ryancorp/EEG-Portfolio/hardware/Breadboard.jpg

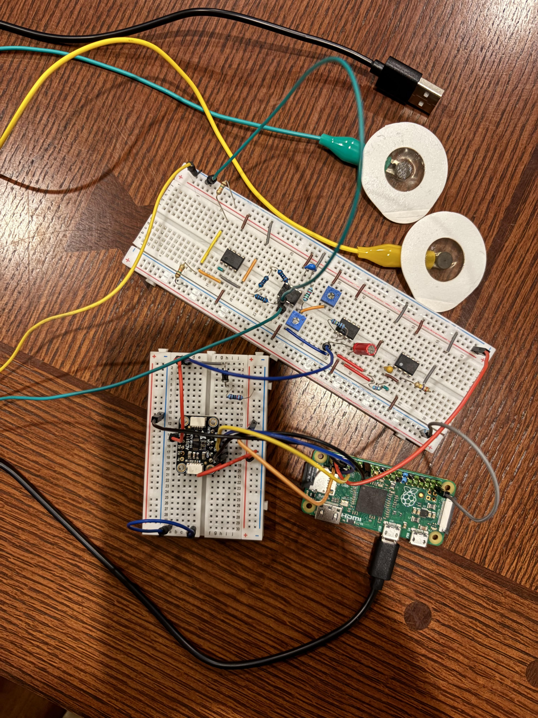
hardware/Breadboard.jpg
