ryancorp/EEG-Portfolio/data_acquisition/Waveform.png

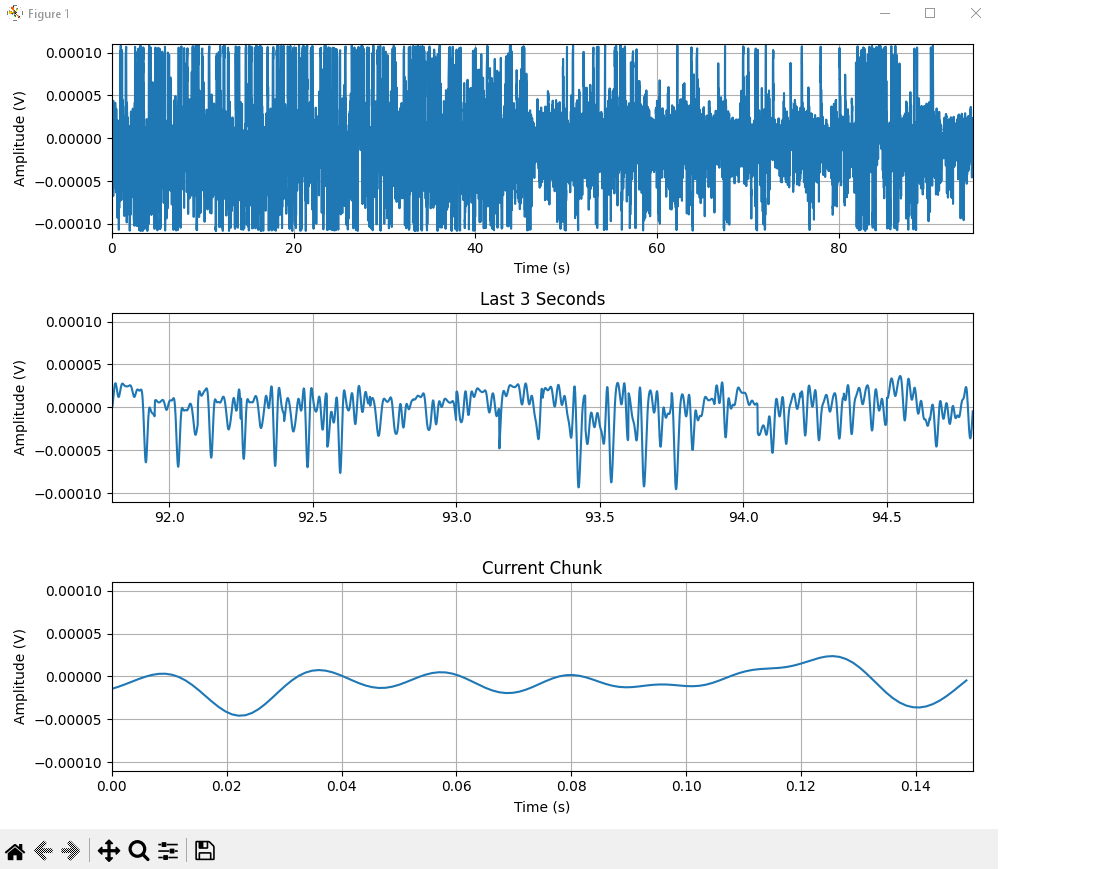
data_acquisition/Waveform.png
