ryancorp/EEG-Portfolio/feature_extraction/Feature_Extraction.png

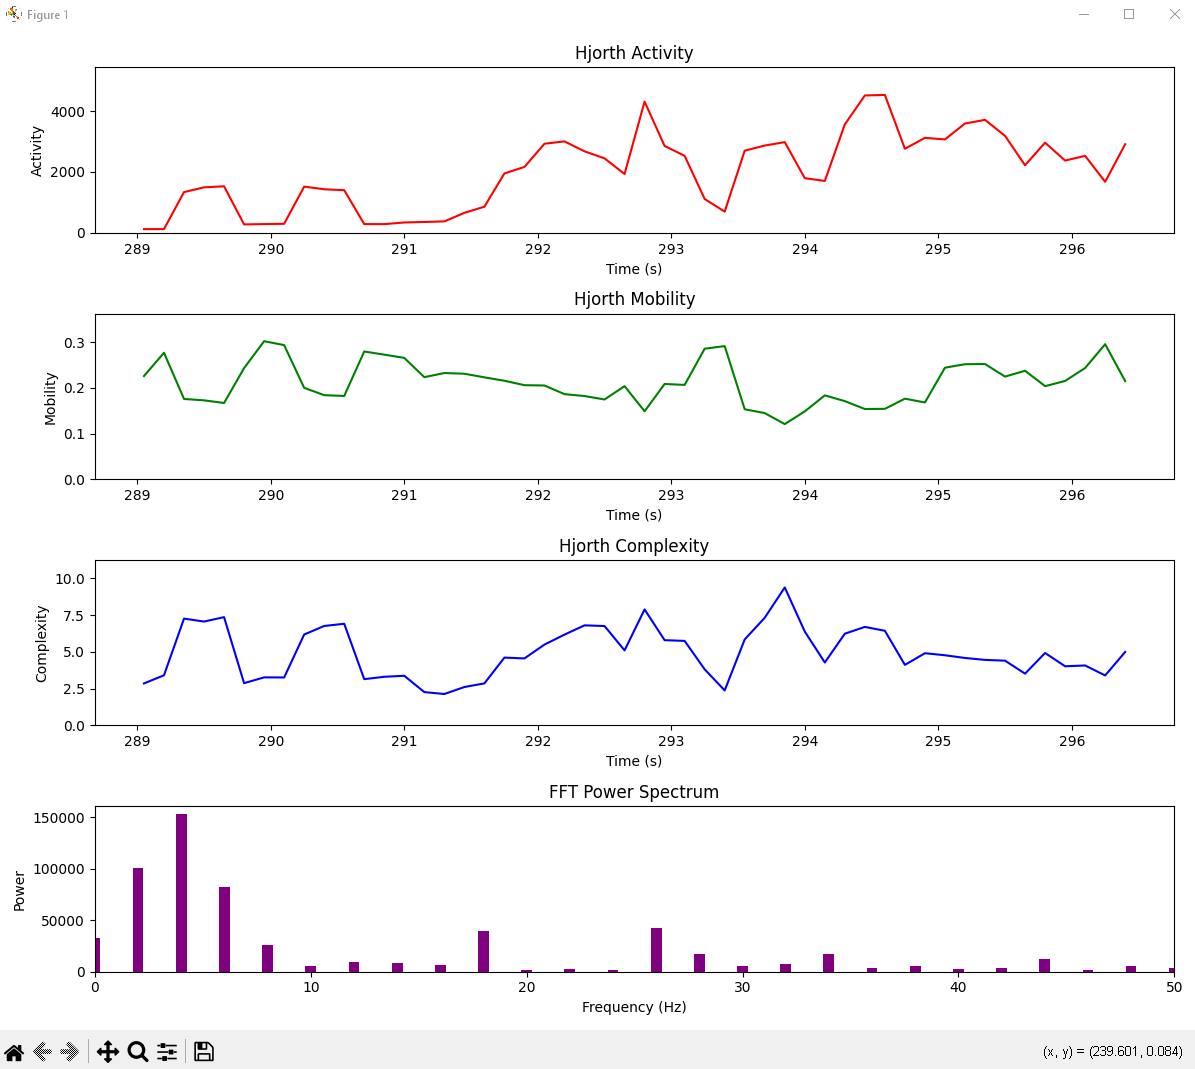
feature_extraction/Feature_Extraction.png
