ryancorp/EEG-Portfolio/hardware/EEG_Circuit.pdf

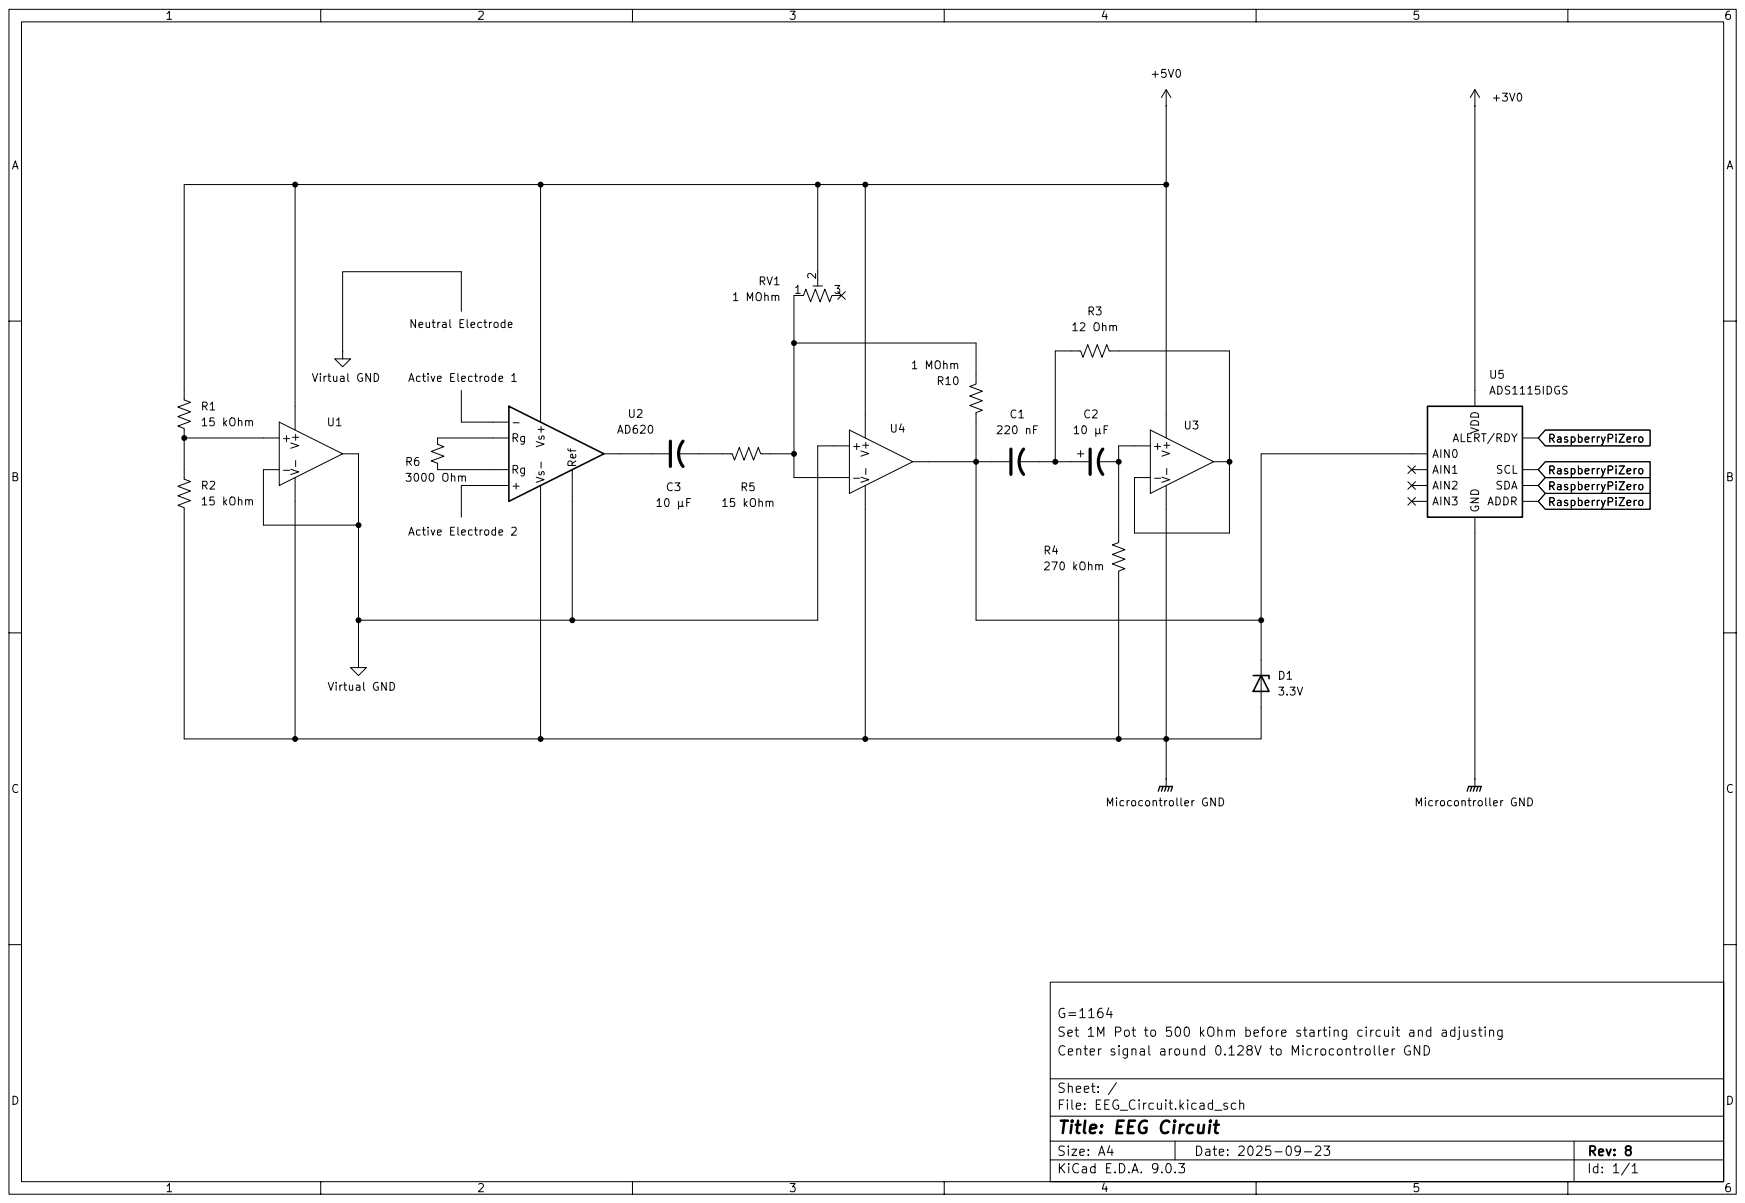
[picture p4: page 1]
