ryancorp/EEG-Portfolio/hardware/EEG_Differential_Mode_ADC_For_Full_Scale_Range.pdf

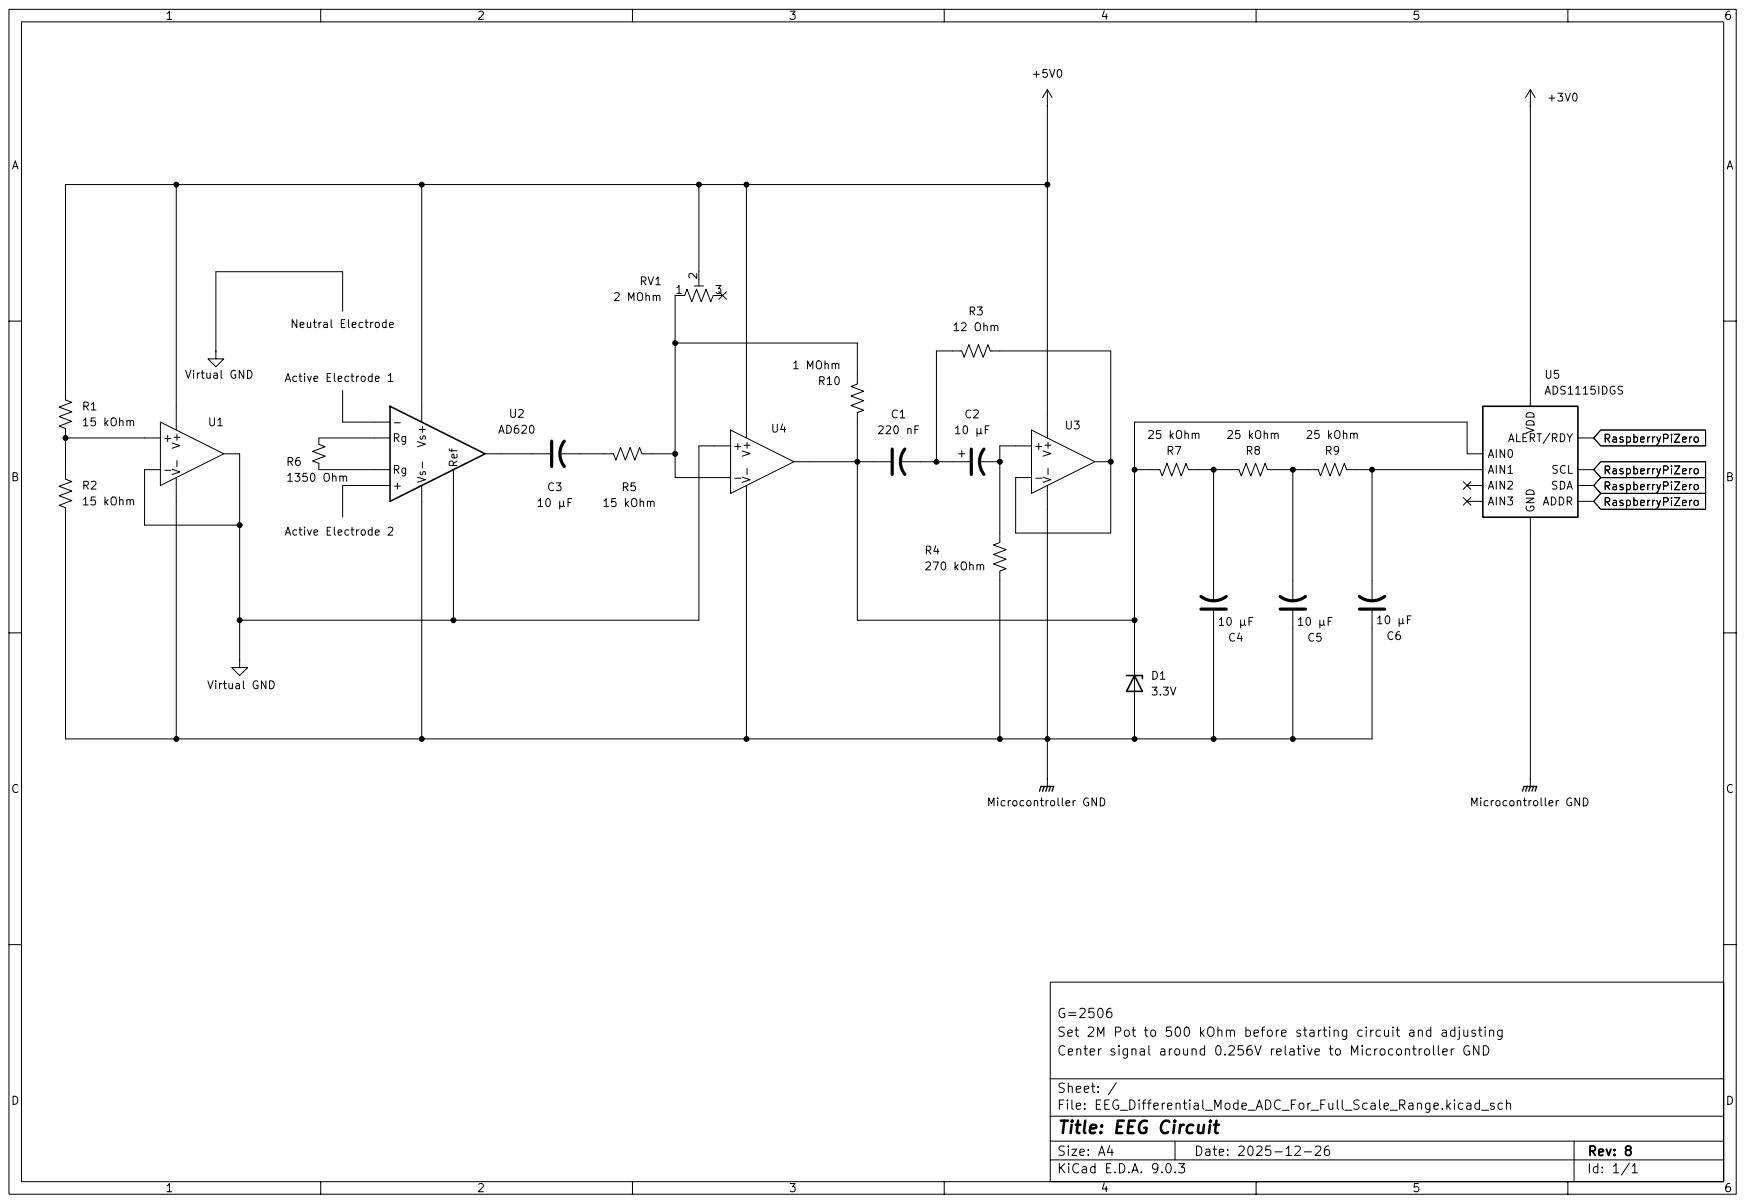
[picture p5: page 1]
