ryancorp/EEG-Portfolio/hardware/EEG LTspice Simulation/EEG_Differential_Into_ADC_For_Full_Scale_Range.asc

C1: cap; 10u
C2: cap; 220n
C3: cap; 10u
C4: cap; 10u
C5: cap; 10u
C6: cap; 10u
D1: diode; 3V3Zener
R1: res; 15k
R2: res; 15k
R3: res; 1350
R4: res; 15k
R5: res; 1Meg
R6: res; 1.114Meg
R7: res; 25k
R8: res; 270k
R9: res; 12
R10: res; 25k
R11: res; 25k
U1: UniversalOpAmp
U2: UniversalOpAmp
U3: UniversalOpAmp
V1: voltage; 5
V2: voltage; SINE(0.0 45u 15 0 0 0); Rser=10k Cpar=10n
V3: voltage; SINE(0 50u 40 0 0 97); Rser=10k Cpar=10n
X1: AD620
Named nets: 0
.lib AD620.lib
.tran 20
.model 3V3Zener D(Vrev=3.3 Ron=0.1 Roff=1Meg VFWD=0.7 Ibvl=1m Nbv=100)
