ryancorp/EEG-Portfolio/hardware/EEG LTspice Simulation/EEG.asc

C1: cap; 10µ
C2: cap; 220n
C3: cap; 10µ
R1: res; 15k
R2: res; 15k
R3: res; 3000
R4: res; 15k
R5: res; 1Meg
R6: res; 1.054Meg
R8: res; 270k
R9: res; 12
U1: UniversalOpAmp
U2: UniversalOpAmp
U3: UniversalOpAmp
V1: voltage; 5
V2: voltage; SINE(0.2 25u 10 0 0 180); Rser=10k Cpar=10n
V3: voltage; SINE(0 25u 15 0 0 0); Rser=10k Cpar=10n
X1: AD620
Named nets: 0
.lib AD620.lib
.tran 1
