ryancorp/EEG-Portfolio/(commit log)

2025-07-27 remove old circuit diagram
2025-07-30 Project goals, circuit design, and sources
2025-08-01 Simscape output exploration
    [simscape_output.csv]
2025-08-02 Updated to emulate ADC data stream.
2025-08-30 op-amp + to virtual GND not GND
2025-09-01 Changed to 5V Microcontroller PWR
2025-09-02 Fixed Circuit Diagram
2025-09-13 Fixed chunk serial logic
    [i2c_read_loop_and_preprocessing.py]
2025-09-21 Delete hardware/EEG_Characterization_Model.slx
    Deleted due to updated circuit diagram and change to LTspice
2025-09-21 LTspice Circuit Simulation
2025-09-21 Changes to Summing Amp and Notch Filter Order
2025-09-23 Removed extraneous high pass filter
2025-09-24 Fixed Resistor Value
2025-09-24 Fixed Resistor Value and Source Voltages
2025-09-24 Added back high pass filter
2025-09-24 Now offset is based on Microcontroller GND instead of Virtual GND
2025-10-06 New circuit design
2025-10-28 Fixed High-Pass Filter Value
2025-10-29 Reworked some text and added single ADC option
2025-11-27 Changed Voltage Protection Circuit
2025-11-27 Fixed Zener Diode Count
2025-12-27 Moved Ground for Clarity
2025-12-29 Enables differential ADC via reference filter
    This is an untested revision of the circuit that introduces a low-pass filter to generate a time-averaged reference signal that approaches the bias voltage set by the voltage adder. This reference is routed to a second ADC input alongside the primary signal, allowing the ADS1115 to operate in differential mode. As a result, the effective input range is expanded to ±0.256 V rather than 0–0.256 V.
    Although the reference signal may exhibit slight variations, the low cutoff frequency (0.016 Hz) and corresponding 10 s time constant ensure that the output closely approximates a DC reference level.
    Some resistor values have been changed from th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
2025-12-29 Expands ADC range via differential mode
    Some resistor values have been changed from the sing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
2025-12-29 LT spice simulation for differential mode
    Some resistor values have been changed from the si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
2026-01-04 Add files via upload
    The previous EEG prototype used the ADS1115 in single-ended mode, which limited the usable signal range. By adding a 3rd-order low-pass filter to obtain the mean voltage, the ADC can now run in differential mode and use its full input range, with only a minor impact on signal accuracy.
2026-01-04 Improved readability of the circuit in Appendix B
